JAHSEHXKYLE/airQualityMonitor_1_BETA/README.md

# airQualityMonitor_1
ESP32-Based Air Quality Monitoring Device.
*** 
## 计划
* 在设备第一次被使用的时候需要配置联网，在设备无法连接到wifi时OR连接wifi后无法上网时需要配置网络。
* 配置网络时需要192.168.4.1显示wifi选择和连接的页面，并且保存wifi账号密码以供下次无缝使用。
* 在进行wifi连接并成功联网后进入设备后台管理页面。
