JAHSEHXKYLE/airQualityMonitor_1_BETA/src/main.cpp

/*
    airQualityMonitor-1 项目程序入口
    版本 v1.0 bate
*/

#include <Wire.h>
#include <GxEPD2_2IC_BW.h>  //双IC库
#include <Fonts/FreeMonoBold9pt7b.h>     //字体
#include "Bitmaps400x300.h"    //位图
#include <Wire.h>   //I2C库

#define ENABLE_GxEPD2_GFX 0
#define CS0 1
#define CS1 0
#define DC 3
#define RST 2
#define BUSY 10
GxEPD2_2IC_BW<GxEPD2_2IC_420_A03, GxEPD2_2IC_420_A03::HEIGHT> display(GxEPD2_2IC_420_A03(CS0, CS1, DC, RST, BUSY)); // 墨水屏GDEH042A03-A1引脚定义

#define BMP_ADDR 0x76 // I2C地址 SDO引脚低电平为0x76 高电平为0x77
#define AHT10_ADDR 0x38 // I2C地址

#define SC8Pin 6 // 二氧化碳传感器PWM输出引脚

double temp_act = 0.0, press_act = 0.0; //定义温度、气压的精确值
unsigned long int temp_raw,pres_raw;
signed long int t_fine;
const uint16_t dig_T1 = 27530, 
            dig_P1 = 36653;    //BMP280校准系数存储
const int16_t dig_T2 = 26600, 
            dig_T3 = -1000, 
            dig_P2 = -10718, 
            dig_P3 = 3024, 
            dig_P4 = -1071, 
            dig_P5 = 353, 
            dig_P6 = -7, 
            dig_P7 = 15500, 
            dig_P8 = -14600, 
            dig_P9 = 6000; //BMP180校准系数存储
float Temp = 0.0; 
float Humi = 0.0; 

bool led_state = false;

/***************************************温湿传感器 ↓**************************************/
void GetAHT10Data(float* temp_val, float* humi_val);
/***************************************温湿传感器 ↑**************************************/


/***************************************气压传感器 ↓**************************************/
void BMPinit(); //气压传感器初始化
void BMPWriteReg(uint8_t reg, uint8_t data);    //BMP280寄存器写入
void BMPGetData(double* P_var, double* T_var); //获取BMP280数据
unsigned long int calibration_P(signed long int adc_P); //气压校准算法
signed long int calibration_T(signed long int adc_T);   //温度校准算法
/***************************************气压传感器 ↑**************************************/

void setup()
{
    Wire.begin(4, 5);
    Serial.begin(115200);
    Serial.println(">>>BMP280 and AHT10 Sensor Test<<<");
    BMPinit();
    pinMode(SC8Pin, INPUT);
    pinMode(12, OUTPUT);
    pinMode(13, OUTPUT);
    digitalWrite(12, LOW);
    digitalWrite(13, LOW);
}

void loop()
{
    BMPGetData(&press_act, &temp_act);
    GetAHT10Data(&Temp, &Humi);
    Serial.print("Pressure: ");
    Serial.print(press_act);
    Serial.print("Pa, Temperature: ");
    Serial.print(temp_act);
    Serial.print(" C, Humidity: ");
    Serial.print(Humi);
    Serial.print(" %, AHT10 Temperature: ");
    Serial.print(Temp);
    Serial.println(" C");
    digitalWrite(12, led_state);
    led_state = !led_state;
    digitalWrite(13, led_state);
    delay(100);
}

void GetInterrupt(float *WidthVal)
{
    unsigned long LOWvalue = 0;
    unsigned long HIGHvalue = 0;
    unsigned long stateVal = 0;
    while(digitalRead(SC8Pin) == LOW); // 等待低电平 
    stateVal = micros(); // 获取并存储当前时间防止卡死
    while (digitalRead(SC8Pin) == HIGH) {
        LOWvalue = micros(); // 获取当前时间
        if (LOWvalue - stateVal > 2000000){
            Serial.println("Error: Pulse width too long!");
            break;
        }
    }
    stateVal = micros(); // 获取并存储当前时间防止卡死
    while (digitalRead(SC8Pin) == LOW){
        HIGHvalue = micros(); // 获取当前时间
        if (HIGHvalue - stateVal > 2000000){
            Serial.println("Error: Pulse width too long!");
        break;
        }
    }
    Serial.println(LOWvalue); // 打印低电平时间
    Serial.println(HIGHvalue); // 打印高电平时间
    *WidthVal = (((1004000 - (HIGHvalue - LOWvalue)) / 1000)-2)*5; // 计算脉冲宽度
}

void GetAHT10Data(float* temp_val, float* humi_val)
{
    int data[6], err;
    Wire.beginTransmission(AHT10_ADDR);
    err = Wire.endTransmission();
    if (err!= 0){
        Serial.print("[err 101]: endTransmission failed with error code: ");
        switch (err)
        {
        case 1:
            Serial.println("1");
            break;
        
        case 2:
            Serial.println("2");
            break;
        case 3:
            Serial.println("3");
            break;
        case 4:
            Serial.println("4");
            break;
        }
    }
    else{
        Wire.requestFrom(AHT10_ADDR, 6, 1);
        if(Wire.available() == 6)
        {
            for (int i = 0; i < 6; i++)
            {
                data[i] = Wire.read();
            }
            if ((data[0] & 0x08) == 0)
            {
                Wire.beginTransmission(AHT10_ADDR);
                Wire.write(0xE1);
                Wire.write(0x08);
                Wire.write(0x00);
                Wire.endTransmission();
            }
            else
            {
                //Serial.println("no need init");
                Wire.beginTransmission(AHT10_ADDR);
                Wire.write(0xAC);
                Wire.write(0x33);
                Wire.write(0x00);
                Wire.endTransmission();
                delayMicroseconds(75);
                if (data[0] & 0x80 == 0)
                {
                    //Serial.println("sensor busy");
                    // Serial.println(Wire.read());
                    delayMicroseconds(75);
                }
                else
                {
                    //Serial.println("sensor not busy");
                    // Serial.println(Wire.read());
                }
            }
            int humi_raw = ((data[1] << 12) | (data[2] << 4)) | (data[3] >> 4);
            int temp_raw = ((data[3] & 0x0f) << 16) | (data[4] << 8) | data[5];
            *humi_val = (humi_raw / pow(2, 20)) * 100.0;
            *temp_val = (temp_raw / pow(2, 20)) * 200.0 - 50.0;
        }else{
            Serial.println("Error000: not enough data received from AHT10");
        }
    }
}

void BMPinit(){
    uint8_t osrs_t = 5;             //Temperature oversampling x 16     20 bit / 0.0003 °C
    uint8_t osrs_p = 5;             //Pressure oversampling x 16     20 bit / 0.16 Pa
    uint8_t mode = 3;               //Normal mode
    uint8_t t_sb = 1;               //Tstandby 62.5ms
    uint8_t filter = 2;             //Filter on 0.082 x ODR  Filter打开后只能在Normal模式下使用
    uint8_t spi3w_en = 0;           //3-wire SPI Disable

    uint8_t ctrl_mesa_reg = (osrs_t << 5) | (osrs_p << 2) | mode;
    uint8_t config_reg = (t_sb << 5) | (filter << 2) | spi3w_en;

    BMPWriteReg(0xE0, 0xB6); // 传感器config复位
    BMPWriteReg(0xF4, ctrl_mesa_reg); // 开启温度高精度模式、大气采样高精度模式、设置传感器为Normal mode
    BMPWriteReg(0xF5, config_reg); 
}

void BMPWriteReg(uint8_t reg, uint8_t data){
    Wire.beginTransmission(BMP_ADDR);
    Wire.write(reg);
    Wire.write(data);
    Wire.endTransmission();    
}

void BMPGetData(double* P_var, double* T_var){ //获取BMP280数据
    int i = 0;
    uint8_t data[6];
    Wire.beginTransmission(BMP_ADDR);
    Wire.write(0xF7);
    Wire.endTransmission();
    Wire.requestFrom(BMP_ADDR, 6);
    if (Wire.available() == 6)
    {
        while (Wire.available()) {
            data[i] = Wire.read();
            i++;
        }
        pres_raw = (data[0] << 12) | (data[1] << 4) | (data[2] >> 4);   //读取原始数据
        temp_raw = (data[3] << 12) | (data[4] << 4) | (data[5] >> 4);
        Serial.print("PressureYUANSHI: ");
        Serial.print(pres_raw);
        Serial.print("   TemperatureYUANSHI: ");
        Serial.print(temp_raw);
        *P_var = calibration_P(pres_raw)/100.00;
        *T_var = calibration_T(temp_raw)/100.00;
    }else{
        Serial.println("Error002: not enough data received from BMP280");
    }
}

signed long int calibration_T(signed long int adc_T) //温度校准算法
{
    signed long int var1, var2, T;
    var1 = ((((adc_T >> 3) - ((signed long int)dig_T1<<1))) * ((signed long int)dig_T2)) >> 11;
    var2 = (((((adc_T >> 4) - ((signed long int)dig_T1)) * ((adc_T>>4) - ((signed long int)dig_T1))) >> 12) * ((signed long int)dig_T3)) >> 14;
    t_fine = var1 + var2;
    T = (t_fine * 5 + 128) >> 8;
    return T;
}

unsigned long int calibration_P(signed long int adc_P) //气压校准算法
{
    signed long int var1, var2, valt1, valt2, T;
    unsigned long int P;
    var1 = (((signed long int)t_fine)>>1) - (signed long int)64000;
    var2 = (((var1>>2) * (var1>>2)) >> 11) * ((signed long int)dig_P6);
    var2 = var2 + ((var1*((signed long int)dig_P5))<<1);
    var2 = (var2>>2)+(((signed long int)dig_P4)<<16);
    var1 = (((dig_P3 * (((var1>>2)*(var1>>2)) >> 13)) >>3) + ((((signed long int)dig_P2) * var1)>>1))>>18;
    var1 = ((((32768+var1))*((signed long int)dig_P1))>>15);
    if (var1 == 0){
        return 0;
    }    
    P = (((unsigned long int)(((signed long int)1048576)-adc_P)-(var2>>12)))*3125;
    if(P<0x80000000){
       P = (P << 1) / ((unsigned long int) var1);   
    }
    else{                  
        P = (P / (unsigned long int)var1) * 2;    
    }
    var1 = (((signed long int)dig_P9) * ((signed long int)(((P>>3) * (P>>3))>>13)))>>12;
    var2 = (((signed long int)(P>>2)) * ((signed long int)dig_P8))>>13;
    P = (unsigned long int)((signed long int)P + ((var1 + var2 + dig_P7) >> 4));
    return P;
}
