JAHSEHXKYLE/airQualityMonitor_1_BETA/test/测试工具/UV_test_code.cpp

#include <Arduino.h>
#include <pins_arduino.h>

void setup() {
    pinMode(18, INPUT);
    Serial.begin(115200);
}

void loop() {
    int sensorValue;
    long  sum=0;
    for(int i=0;i<1024;i++)
     {  
        sensorValue=analogRead(18);
        sum=sensorValue+sum;
        delay(2);
     }   
   sum = sum >> 10;
   Serial.print("The voltage value:");
   Serial.print(sum*4980.0/1023.0);
   Serial.println("mV");
   delay(20);
   Serial.print("\n");
}
