JAHSEHXKYLE/airQualityMonitor_1_BETA/(commit log)

2024-11-26 针对合宙esp32进行调整
2024-11-26 Add 合宙esp32c3测试代码
2024-11-26 添加SC8传感器的测试驱动程序
2024-11-26 SC8传感器测试驱动程序
2024-11-27 优化SC8传感器驱动
2024-11-27 优化SC8传感器，添加PG2Y10 pm2.5传感器驱动
2024-11-29 备份上传
2024-11-29 添加config前端的网页源码
2024-11-30 html修改
2024-12-01 添加test测试版config页面
2024-12-01 添加水印html文件
2024-12-02 多设备通用页面优化
2024-12-02 优化设置页面和监控页面的布局
2024-12-02 增添导航栏淡入淡出颜色渐变效果
2024-12-03 文件分类并在main文件中添加水印logo旋转
2024-12-03 添加页面启动过渡，主要内容页面过渡
2024-12-03 暂停config网页开发
2024-12-06 添加wifi功能测试
2024-12-07 针对tcp通讯进行测试
2024-12-09 设备数据tcp协议读取并显示
2024-12-12 添加esp32官方文件
2024-12-12 修复错误 T-T
2024-12-20 测试通过wifi进行客户端服务端数据传输
2024-12-22 i2cBUG彻底解决！！
2024-12-29 成功在web内显示
2024-12-30 修改网页文字显示BUG
2024-12-31 测试wifi搜索
2025-01-09 批量无计划提交
2025-01-10 测试WiFIScan功能
2025-01-10 添加从web提交的功能并测试
2025-01-12 进度提交
2025-01-13 模拟json数据接收
2025-01-15 优化wifi扫描功能
2025-01-15 完成wifi扫描功能
2025-01-15 针对SPIFFS功能进行测试
2025-01-18 initConfig页面测试成功
2025-01-18 优化完善联网功能
2025-01-21 添加web端post请求发送wifi数据
2025-01-24 添加wifi账号密码记忆功能 最多记忆5个wifi的密码 超过5个的wifi信息将自动覆盖至 最原始的数据上
2025-01-25 添加并优化wifi连接功能，完善对POST请求返回值的处理
2025-01-25 修复POST返回数据 处理错误的BUG
2025-01-27 BUG暂时解决不了，存档。（在Ap模式下设备进行联网后，自动进入STA模式，但是在STA模式的web界面内无法更换网络，服务端的server.send()无法使用，客户端接收超时报错）
2025-01-28 BUG以规避 （BUG产生的原因是esp32在STA模式下进行wifi.begin()时，会导致现有的服务端与客户端的链接强行断开，导致web页面等待时间超时产生错误，解决方法：在STA模式下不进行网络配置，需要网络配置时让设备先进入AP模式，然后连接到网络。）
2025-02-01 在对PMS7003i进行测试的时候并没有找到相关资料
2025-02-11 PMS7003I 驱动已经测试完成
2025-02-11 wifi自动连接、密码记忆、连接页面、连接跳转各项功能已经完善
2025-02-12 ccs811第三方库已下载
2025-02-17 代码合体准备
2025-02-17 代码整合准备
2025-02-19 墨水屏测试
2025-02-20 界面测试
2025-02-20 图标测试
2025-02-20 布局上机测试
2025-02-22 整合传感器功能
2025-02-22 界面布局设计更新
2025-02-22 界面布局优化
2025-02-25 数显功能测试
2025-02-26 数据手册更新
2025-02-26 上传手册
2025-03-14 汇总上传
2025-03-14 添加第三方库，更新测试代码并成功通讯
2025-03-16 针对小智AI进行测试
2025-03-19 整备上传
2025-03-19 彻底解决BMP28读数错误BUG
2025-03-19 优化算法 增加传感器驱动
2025-03-19 优化参数匹配显示器黑白平衡
2025-03-19 测试上传
2025-03-19 补全驱动代码
2025-03-19 补全代码
2025-03-21 针对屏幕老化优化全局刷新
2025-03-21 添加资料
2025-03-21 对屏幕老化进行测试
2025-03-21 分类整理
2025-04-03 无用更新
2025-05-05 超级大更新
2025-05-07 优化结构
2025-05-07 添加数据库功能
2025-05-07 导出spiffs文件测试
2025-05-08 论文上传存留
2025-05-08 功能测试修改
2025-05-12 版本更新 添加超出标准高亮显示功能
2025-05-12 保存修改
2025-05-19 保存提交[本地文件损坏]
2025-05-19 本地文件损坏保存
2025-06-03 整备更新[准备加入ai功能]
2025-06-06 Aeris Ai移植成功
    [CONFIG_16MB.csv]
